Reavenous/Godiny/Godiny.png

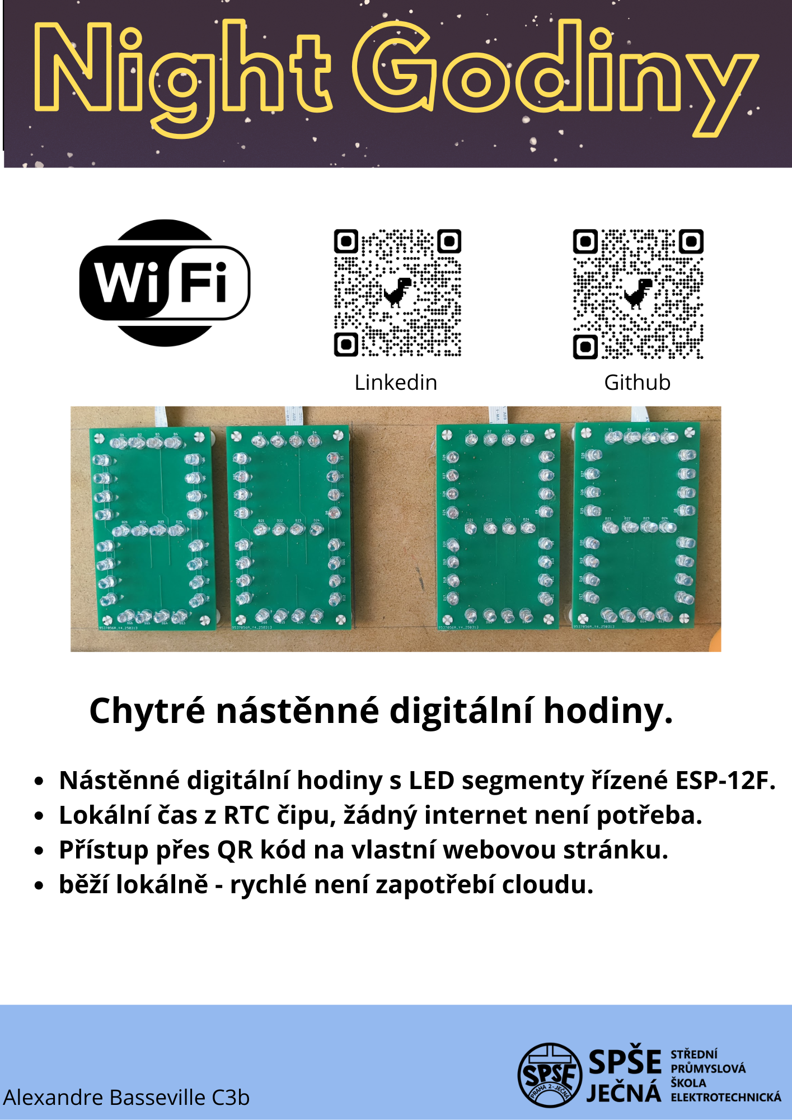
Godiny.png
