Reavenous/Godiny/godiny.pdf

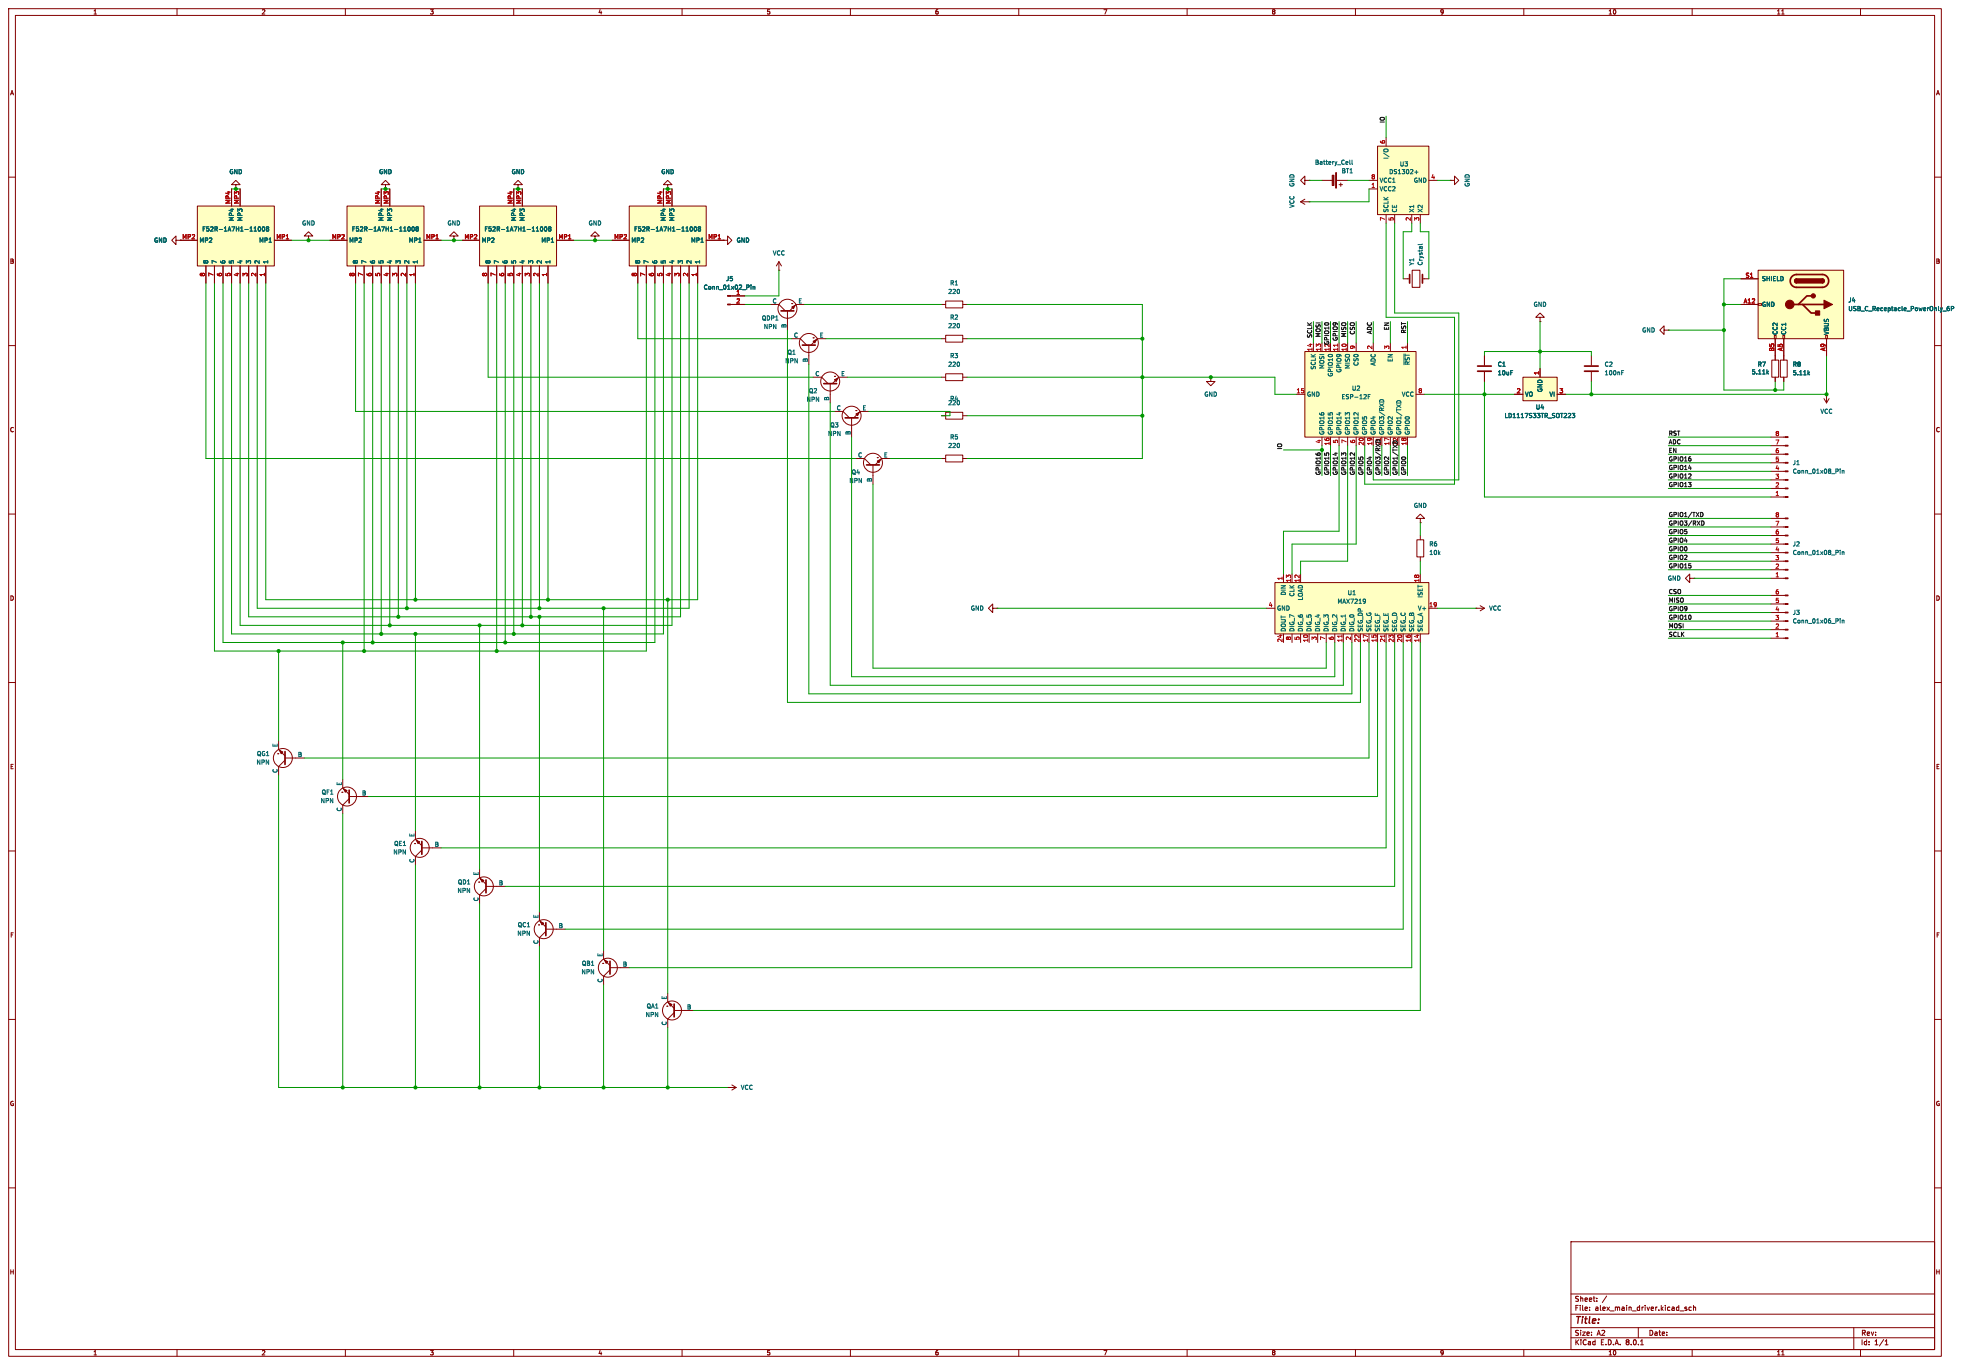
[picture p4: page 1]

10uF ~{RST}1 MISO 10 GPIO9 11 GPIO10 12 MOSI 13 SCLK 14 GND
